free-dmo/free-dmo-stm32/(threads)

Thread 1 (2022-03-29):

CRC algorithm

garci66, 2022-03-29:
Not sure if it helps (and sorry for opening an issue). But in the past I've used this tool to brute force unknown CRC checksums and find the coefficients. https://github.com/nitram2342/bruteforce-crc

Means we probably need a few different samples, but I've used it to decode a protocol with its own CRC and this tool helped me find the proper coefficients. Hope it helps !!!

freepdk, 2022-03-29:
I tried to brute force the poly already. No luck for me.

freepdk, 2022-03-29:
In case you want to try yourself, here one data block (common in all read outs):
```
static const uint8_t crcblk1[] = {
  0x00,0x00,0x00,0x00, 0x00,0x00,0x00,0x00, 0x00,0x00,0x00,0x00, 0x00,0x00,0x00,0x00,
  0x00,0x00,0x00,0x00, 0x00,0x00,0x00,0x00, 0x00,0x00,0x00,0x00, 0x00,0x00,0x00,0x00,
  0x00,0x00,0x00,0x00, 0x00,0x00,0x00,0x00,
};
```
CRC for this is: 0x913ec3dd (or 0xddc33e9 - depending on byte order).

Another one to verify:
```
static const uint8_t crcblk2[] = {
  0x01,0x00,0x00,0x00, 0x00,0x00,0x00,0x00, 0x00,0x00,0x00,0x00, 0x00,0x00,0x85,0x30,
  0xE1,0x07,0x00,0x00, 0x00,0x00,0x00,0x00,
};
```
CRC for this is: 0x8723b272 (or 0x72b22387 - depending on byte order).

garci66, 2022-03-29:
Thanks. Let me see

kategray, 2022-03-29:
Doesn't look like a standard CRC32 algorithm, if the input is correct.

https://crccalc.com/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

dtomcat, 2022-04-13:
If your question/issue is resolved, please close the issue so attention can be focused on open issues.

eychei, 2022-07-18:
Looking into this right now.
How did you find out the block size for the crc?
Do you have a memory map of the Tag data which you identified already?

Thread 2 (2022-03-31):

5XL

dtomcat, 2022-03-31:
Not really an issue (that I know of). But this should work with 5XL right?  Thanks

freepdk, 2022-04-03:
The logic will work 100% for sure.
Just the wiring might be different. In case you have some pictures of the main pcb and the RFID board of the 5XL this could be answered easily.

dtomcat, 2022-04-03:
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

As Requested.

freepdk, 2022-04-04:
The RFID board is identical to the one in the 550. This means the exact same mod will work for the 5XL as well.

To your question regarding the STM32 "compatible" ICs... Hard to tell if it works or not. The firmware uses I2C which might or might not be cloned in a good way... You have to try.

dtomcat, 2022-04-14:
This works with 5XL (confirmed)

Closed 2022-04-04.

Thread 3 (2022-03-31):

Describe RFID board

stappersg, 2022-03-31:
Currently there is no information the RFID board.
It is only seen in a photo.

Please describe the RFID board.

freepdk, 2022-04-03:
The RFID board is very boring. It is just a CLRC663 RFID IC (used in I2C mode) and an RFID antenna.

The NXP datasheet of CLRC663 has all the details: https://www.nxp.com/docs/en/data-sheet/CLRC663.pdf

dtomcat, 2022-04-13:
If your question/issue is resolved, please close the issue so attention can be focused on open issues.

stappersg, 2022-04-14:
@dtomcat  You are right,  thanks for reminding me to do this.

Since a few moments there is merge request #11

Closed 2022-04-14.

Thread 5 (2022-04-04):

How Accomplished

0Kills, 2022-04-04:
This isn't an issue, but are you able to detail how you reverse engineered the protocol/tag format and how it works? I cracked open a 550 and tried to get started reversing the pins between the board and the daughterboard, but I got lost in the process. How did you determine it was I2C, how were you able to reverse the protocol, and how does the protocol work?  Does the digital signature not also sign the blocks that hold the label count? Seems almost pointless for them to use a digital signature when it can just be copied byte for byte.

freepdk, 2022-04-05:
First you identify the ICs on the main board.

==> You learn it is a STM32F072

Then you look at the pinout of the STM32F072 and identify which pins go to the connector for the RFID board.

==> here you learn they are 2 x I2C pins, 1 x GPIO pin, 1 x 3V3, 1 x GND, and 1 pin unknown (this we identify later when looking at the RFID board)

Now you look at the RFID board and identifiy the RFID IC from NXP: CLRC663

==> Again you look at the data sheet and trace the pins ==> you confirm I2C, 3V3 and GND. Then you identify the GPIO pin is connected to IRQ and the unknown pin is in fact PowerDown.

Since you now know all the pins from the cable between main board and RFID board you attach a logic analyzer (e.g. Saleae Logic 8 - or any cheap logic analyzer you can find).

Usually the logic analyzer is having some software which you can use to decode the data (e.g. I2C).

==> You now have the byte stream going in and out via I2C (see here: https://www.eevblog.com/forum/reviews/dymo-550-thermal-printer-drm-hacking/msg4047715/#msg4047715)

Now again you read the CLRC663 data sheet to understand the data going in and out.

==> You find the commands which is just set up the CLRC633 and also the data which is sent to the real tag presented to the reader and also the response from the tag.

Now you look up the data sheet for the tag: NXP SLIX2  and find the meaning of the data sent:

- read UID
- read signature
- read data blocks
- write counter
...

All what is left is to capture the data which is sent / received from real tag and write an emulation to play back this data.

freepdk, 2022-04-05:
> Does the digital signature not also sign the blocks that hold the label count? Seems almost pointless for them to use a digital signature when it can just be copied byte for byte.

The signature is in the SLIX2 specification which just signs the UID (8 byte ID) of the tag.
D.MO at least uses their own signature (own ECC priv key to sign in factory, pub key to verify in firmware), but like you mentioned this does not protect from replay.

==> All in all THIS WAS NOT DESIGNED TO BY SECURE (no intention visible from D.MO).

Like I mentioned before. They used the wrong security scheme... maybe they had to save money :-P

0Kills, 2022-04-05:
Couldn't they conceivably have the private key in a secure enclave inside the device to digitally sign new data blocks after decrement without exposing the key?
Also I've just dumped the data from the 25 x 54mm labels. What is the best way to get to you to add new label emulation?

freepdk, 2022-04-06:
They could have done many things differently... But I see no point in discussing ideas here which would help them or others to make a "better" system. The complete idea is WRONG!

You can attach the dump .txt file here (When you comment here, there is a small text below the edit box "Attach files by dragging...")

0Kills, 2022-04-06:
[E0040108449690ED_20220405143943.txt](https://github.com/free-dmo/free-dmo-stm32/files/8426840/E0040108449690ED_20220405143943.txt)

Good point about not helping them. Label dump for 25x54mm is attached. Thanks for all your hard work.

freepdk, 2022-04-06:
Thanks for the dump. Intgerated with commit: 89fa322

dtomcat, 2022-04-13:
If your question/issue is resolved, please close the issue so attention can be focused on open issues.

RyanEwen, 2023-09-27:
This is great. I have a Zebra ZSB-DP14 thermal label printer which uses refills equipped with tiny little PCBs, just big enough to house 3 pads that align with 3 pins in the printer. I'm hoping to figure out what is communicated between the refill PCBs and the printer so that I'm not locked into their expensive refills.

hinakhan09, 2024-07-11:
Download Now https://pclife.info/dymo-connect-crack/

Thread 6 (2022-04-05):

QUESTION: Compatibility with 5XL

malebuffy, 2022-04-05:
Would this work with the 5XL as well?

freepdk, 2022-04-05:
Was discussed in issue #2 .

==> Should work, since reader board is identical which means the pinout on main board must be also identical.

dtomcat, 2022-04-13:
If your question/issue is resolved, please close the issue so attention can be focused on open issues.

Closed 2022-04-13.

Thread 9 (2022-04-12):

Ready bins

netboy69, 2022-04-12:
Hi, can we please have all bins for all kind of labels? So we dont have to compile or use the reader from the printer? Regards

dtomcat, 2022-04-13:
IMHO if you’re unable to compile… you should probably not do this mod.   The creator has given you everything you need. It would be a lot of work to keep updating bins with each possibility

netboy69, 2022-04-13:
I'm able to compile but just didn't work, if i try the bin that is already done works perfect, but that's not the size of labels that i use. That's why I'm was just asking if anyone can do it. But thanks anyway I'll find a way. Kind regards

dtomcat, 2022-04-13:
What issues are you having? Perhaps the community can help. My blue pills arrive tomorrow so I’ll be attempting everything tomorrow.  The bin is created?  You program the chip and it doesn’t work?  Checked all connections?

netboy69, 2022-04-13:
I got the blue pill and the programer for the pill, but i was missing the 4.7om resisters , so i thought just to use the pill to try, I've change the code to match the label i wanted, compile all under Ubuntu got the final bin, content the pill to printer and wouldn't detect the label size, with the original bin already compiled the printer assume a label no problem. Today i should receive the 4.7 om resisters so I'll build the all thing. And see. Regards

netboy69, 2022-04-13:
Also I'm trying on a 5xl because the original bin worked fine I'll assume all should work 100%, I'll post my result soon and if i manage to compile the bins correctly I'll post them all here it's just quicker, compiling takes time when you do it first time. Regards

freepdk, 2022-04-13:
I created a github workflow which automatically compiles all variants for new releases.
Have a look at the main page / releases section where you can download a ZIP file containing firmwares for all default emulation variants.

netboy69, 2022-04-13:
Omg you are the man, thanks alot, can't wait to get home and program the blue pill. I wanted to do that but I dont know why my bin didn't work because Ubuntu show no errors. One more time many thanks for that. Have a great day.

freepdk, 2022-04-13:
Unfortunately (or fortunately?) I do not have a 5XL.

Since the printer has a different main MCU it might be that they have differences in their firmware implementation which might need some tweaks to the emulation.

However you reported your 5XL with the pre compiled firmware worked already :-)

One thing to note, after changing the firmware on the blue pill, make sure to power cycle the printer completely (remove USB and POWER for 5 seconds). Mine gets upset when I change the blue pill firmware while the printer is running (I use the SWD pins connected to ST-Link, so I can use debugger).

netboy69, 2022-04-13:
By the end of the day I'll post all results, but yes the 5xl worked fine with the default label on the freedom.bin, I'll report the rest later on. Kind regards

netboy69, 2022-04-13:
Hi every one, so here my results on a Dymo 5XL, first tests were made with the STM32 blue pill only and not connected to the reader, i have tested all bins files and the results were: freedmo-default-sku-S0722400_36x89mm.bin, freedmo-default-sku-S0722430_54x101mm.bin and freedmo-default-sku-S0722550_19x51mm.bin the printer detects the label and setups it self for the label size on the other bins files it does not detect the label size meaning if you press the right button to skip a or print blank label because the size is wrong it wont skip the blank label, but if you tell the printer to print a 1744907 for example it will print fine and stops ok on the next label and gives no errors. so it can be used like this just remember to setup the size of the bin you programed and will get the job done. Then my next test was to connect to the rfid reader all seem fine but i dont have original label to test if it reads fine and adjust the size, ill see if i can get genuine labels and come back for a result, but so far with the stm32 blue pill alone works fine you dont need to connect to the reader if you only print one kind of labels.

netboy69, 2022-04-13:
No worries, in the end my bin was the same because both had the same result. I just thought I was doing something wrong because it wasn't working like the original bin. In the end i got the 5xl printing on the 6x4 labels bypassing the RFID so happy days and no money for dymo genuine labels. :-)

dtomcat, 2022-04-14:
My update:  Programmed one Blue Pill into an ST-Link V2...   compiled src (src prior to update with github workflow) to use 4x6 labels.  uploaded resulting BIN to a new Blue Pill (via previously mentioned blue pill) and everything works fine. (I think)  I only have 4x6 labels, so I can't tell if it's detecting my labels or not.  Will this auto top off my labels to 50 if it's below that?  and in the src it says 220 labels, but defaults to 50.  Other than that... seems to work.  I may pick up a pack of other labels to see if it recognizes those or not.

So this confirms that it works fully with 5XL if issues noted above are normal.
Thanks for your hard work on this!

dtomcat, 2022-04-14:
so instead of buying new labels, i tried flashing a different firmware... none worked... either it came up 4x6 (no matter which firmware) or only worked with original labels... reflashed the bin I compiled and now it shows 220 labels no matter which label i insert. (4x6)...  the default... if i load generic labels... it shows 220 labels (as expected)... if i load my roll, it shows 220 which rfid tag says there is 50 labels.

Should it show tag amount if genuine labels?  i can't tell if it's reading the labels or not.

netboy69, 2022-04-14:
On the 4x6 labels it won't detect the label but let say you are painting a pdf on the setting chose the correct label size and it will print. I assume by not drying the label size will also don't know how many labels left.

netboy69, 2022-04-14:
Printing not paiting

netboy69, 2022-04-14:
Windows, go to printers then chose the 5xl then settings and chose correct label size.

netboy69, 2022-04-14:
whats new on the firmware 1.0.5?

dtomcat, 2022-04-14:
Looks like he added 1”x1” label to code

netboy69, 2022-04-14:
Ho ok, I'll try when possible. Thanks

dtomcat, 2022-04-15:
4x6 is the only one that I actually got working.  And i figured out, if you have real dymo labels inserted, then every label inserted after keeps the orginal inserted.  i.e. I insert my 4x6 label (real) with 50 remaining... then insert generic label....   it shows up as 4x6 with 50 remaining.   if I power down and power back up... that same roll shows up as 4x6 with 220 labels...   If I insert the real labels... they also show up with 220 remaining.    all the other pre-compiled bins... would not show any labels ... only real labels... not sure whats wrong... but i'll only be using 4x6 labels in the 5xl... so i'm not worried...    i have it working like i need it to.   I have a different size label coming from Amazon to try out.   I'll follow up with the results.

netboy69, 2022-04-15:
Nice, it's like me i only use the 4x6 and it's printing ok so far so let's see if this issue get fixed next updates about detecting the labels. But I'm happy so far because I can use 3rd party labels.

dtomcat, 2022-04-17:
Tried new Labels... after power cycle... Worked great.  Right labels/remain amount showed...

Loaded 4x6 labels... and showed as new labels...  so even if using real labels, you have to power cycle after each change.  Whatever is loaded upon power up... is the only label that shows until another power cycle.

netboy69, 2022-04-17:
Perfect we can live with that.

freepdk, 2022-04-18:
> Tried new Labels... after power cycle... Worked great. Right labels/remain amount showed...
>
> Loaded 4x6 labels... and showed as new labels... so even if using real labels, you have to power cycle after each change. Whatever is loaded upon power up... is the only label that shows until another power cycle.

Hmmm... maybe we can improve on that. On my 550 when you remove a spool (so RFID board can't see it anymore), wait 3 seconds and put in a new spool it shows the new labels with a fresh maximum counter.

Maybe the 5XL needs some other timing... Anyone with a STLinkV2 connected to the bluepill could debug on 5XL?

dtomcat, 2022-04-18:
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

I can probably help.  Just let me know what to do.  I have a home made ST-Link V2… but should work

dtomcat, 2022-04-20:
I’ll be creating another D.MO today for testing (longer leads). Let me know what you need

dtomcat, 2022-04-20:
Test Blue Pill is ready...  not sure how to get the information you need, so waiting on your response.

dtomcat, 2022-04-21:
I could pull the pin out of the connector instead of desoldering.  (To save time and headache) Just let me know whenever you have time and I’ll do my part

dtomcat, 2022-05-04:
Any update on what you need me to do to get you the data you need?  Do I need a special build?

dtomcat, 2022-07-31:
?????  still supporting this?  if so, I'd like to help troubleshoot the 5xl

dtomcat, 2022-08-03:
Ah. Sorry to hear this

dtomcat, 2022-08-03:
Egg grill

dtomcat, 2022-10-25:
Just checking in to see if I can help?  (Troubleshoot the 5xl

Thread 13 (2022-04-21):

6 pin connector

0Kills, 2022-04-21:
The 6 pin connector recommended in the guide does not seem to match the connector on the board.
The one on the board has notches in the front (or back) while this cable has them on the sides. This is a JST ZH 6 pin cable from Amazon: https://www.amazon.com/gp/product/B07Q5F9CCZ/ref=ppx_yo_dt_b_asin_title_o07_s00?ie=UTF8&psc=1
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

dtomcat, 2022-04-21:
This is what I used:
1.25mm Pitch Connectors and Pre-Crimped Cables Compatible with Molex PicoBlade for Pixhawk Silicone 15cm Wire https://www.amazon.com/dp/B07S18D3RN/ref=cm_sw_r_cp_api_i_XMXH33ZB033DANEVMGSC?_encoding=UTF8&psc=1

freepdk, 2022-04-21:
Actually I used the listing title from ebay which was:  "6pin 1.25mm Wire To Board Connector / JST ZH 6pin"

So maybe the listing I purchased from was wrong or the listing you found on amazon is wrong...

0Kills, 2022-04-28:
The link from @dtomcat worked for me.

GigaElectron, 2022-08-26:
@freepdk JST ZH has a 1.5mm pitch, whereas JST **_GH_** has a 1.25mm pitch, the listing you used must have been incorrect. The `README` should be changed to say "JST GH". 👍

freepdk, 2022-08-28:
I changed the README to say GH (see commit 02bf8f9)

soerendohmen, 2023-06-23:
GH is definitely not the correct connector, as you can see on the picture on JST's website: [https://jst.de/product-family/show/89/gh](https://jst.de/product-family/show/89/gh)

queengooborg, 2023-09-15:
It appears that the GH connector is commonly confused with the Molex PicoBlade (MX) connector.  They're both the same pitch (1.25mm).  I've updated the readme on my fork (https://github.com/queengooborg/free-dmo-stm32#required-parts) and will be submitting a PR to help correct this info upstream!

Thread 14 (2022-05-07):

Add SKU S0722540 (32x57mm) in dumped SKUs

BarthV, 2022-05-07:
This ref seems missing in the main.c SKU (& my wife desperately needs it ;D) :

**S0722540 - 32 mm x 57 mm | 1¼ in x 2¼ in - 1.000 labels**
_Dumped using https://github.com/free-dmo/free-dmo-tag-dump_

inventory :
```0x01, 0x49, 0xCA, 0x4D, 0x44, 0x08, 0x01, 0x04, 0xE0```

sysInfo:
```0x0F, 0x49, 0xCA, 0x4D, 0x44, 0x08, 0x01, 0x04, 0xE0, 0x01, 0x3D, 0x4F, 0x03, 0x01```

signature:
```0xE1, 0x59, 0xA4, 0x09, 0x08, 0xF1, 0xE6, 0x00, 0x25, 0x5F, 0x59, 0x96, 0x8C, 0x16, 0x96, 0x7B, 0x81, 0x52, 0xA8, 0x4C, 0x09, 0xDE, 0x4C, 0x2E, 0xDF, 0x9B, 0xB3, 0x65, 0x5C, 0x1E, 0x00, 0x20```

BarthV, 2022-05-07:
will copy the bocks too, and maybe write a PR

Closed 2022-06-17.

Thread 15 (2022-05-21):

STM32F103C6T6

malebuffy, 2022-05-21:
Hi since I have a STM32F103C6T6 around which is not compatible,  I would be interested to know why? Is this a limitation of Hardware or just that the source is written to be compiled for the STM32F103C8T6?

malebuffy, 2022-05-22:
I tried to create a new project with the CubeMX application and use the .ioc file and import it in a STM32F103C6x project. At first seems to work and code is generated, but after that I am kind of struggling. The main difference is that the CubeMX doesn't generate a .ioc file that has I2C2 defined, and it doesn't build.

Any idea what is happening?

malebuffy, 2022-05-23:
So after further diging in, the STM32F103C6T6 has only one I2C channel and the code needs 2, so thats probably why this is not compatible.

Closed 2022-05-23.

Thread 16 (2022-05-28):

How to debug for message: Unknown label detected

malebuffy, 2022-05-28:
Hi guys,

I received my bluepill with what it seams a STM32F103C8x ship on it. At least it looks legitimate. I tried both flashing the bin files and also compiling anf flashing the freedmo.bin. Wire connections are OK, I am using the 4.7k resistors as well in order to be able to recognize different spools.

After flashing, I connect the bluepill to the printer and when I switchit on it says: Unknown Label Detected

No matter which Bin I flash, same thing. Do you have any tips for me how to debug? I am getting kind of desprate...

Thanks for any feedback

malebuffy, 2022-05-29:
Checked all the pins, checked connections. All good. Can it be that because I am using the latest Dymo Software v1.4.3.131 that they blocked the UIDs? Anyone has an older version I could try?

dtomcat, 2022-05-31:
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

also ensure jumpers are right

dtomcat, 2022-05-31:
![Uploading FA5F8487-D94C-433E-9FAC-7502DD37C0E0.jpeg…]()

dtomcat, 2022-05-31:
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

malebuffy, 2022-05-31:
Oh sorry, silly me! Yes, the jumpers are like this. I never touched them.

malebuffy, 2022-05-31:
No problem. So does it work on your 5XL? Do you use an original STM32 or some clone?

dtomcat, 2022-05-31:
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

This is the change for me.  Without troubleshooting, this is how it works for me… but is ok for me as I don’t change labels frequently

malebuffy, 2022-05-31:
I will try to build your fork and report back. BTW do you use original STM32 or clone?

dtomcat, 2022-05-31:
My fork is basically the same… just added a new label. And updated the readme.

As far as I know… it’s original. But cloners are good!

malebuffy, 2022-05-31:
Nothings works. I am starting to think that I have a fake STM and somehow the peripherals are not correctly cloned. I removed the resistors and disconnected the RFID part, still receiving an error. Sadly not easy to debug like an arduino for exampl3 where you just read from serial monitor.

I have ordered a new one to see if I have better results.

malebuffy, 2022-06-01:
Fixed it! It was a bad board. I used another one and remade the connections. It works now without the resistors and the RFID board, but I will try that in the evening and report back!

malebuffy, 2022-06-01:
I did it. Board was the culprit. Bad luck I guess. I can confirm the same behaviour when I have an original roll in. I have to power cycle.

malebuffy, 2022-06-01:
Thanks to dtomcat for the support and to the author for the mod.

dtomcat, 2022-06-01:
No worries. I figured it had to be a bad board if everything else i mentioned was good. Glad you got it working.  And good to know yours functions same as mine.  So must be a timing issue (difference between 550 and 5XL)

Thread 17 (2022-05-31):

Add SKU

malebuffy, 2022-05-31:
104mm x 159mm Label SKU S0904980

```
inventory: 0x01,0x49,0x4E,0xB1,0x44,0x08,0x01,0x04,0xE0
sysInfo: 0x0F,0x49,0x4E,0xB1,0x44,0x08,0x01,0x04,0xE0,0x01,0x3D,0x4F,0x03,0x01
signature: 0x9C,0x42,0x9E,0x45,0x08,0xEF,0xA2,0xA5,0xF0,0x05,0xFC,0x86,0x27,0x37,0x98,0xF5,0xA5,0x9F,0xA2,0x87,0x20,0x9B,0x15,0x09,0x83,0x42,0x8E,0x64,0x3C,0x7A,0xC9,0xB9
blocks:
0x03,0x0A,0x82,0xED,0x86,0x39,0x61,0xD2,0x03,0x14,0x1E,0x32,0xB6,0xCA,0x00,0x3C,0x86,0xD3,0x18,0x6B,0x53,0x30,0x39,0x30,0x34,0x39,0x38,0x30,0x00,0x00,0x00,0x00,0x00,0xFF,0x04,0x01,0x01,0x00,0x00,0x00,0x73,0x06,0x1E,0x00,0x26,0x00,0x00,0x00,0x00,0x00,0x10,0x00,0x3A,0x06,0x14,0x04,0x00,0x00,0x00,0x00,0x33,0x04,0xDC,0x00, 0xF1,0x46,0x16,0x00,0x01,0x00,0x00,0x00,0x00,0x00,0x00,0x00,0x00,0x00,0x00,0x00,0xD7,0xFA,0x00,0x1C,0xEC,0x16,0x52,0x70,0x00,0x30,0x30,0x30,0x30,0x30,0x30,0x30,0x30,0x30,0x30,0x00,0x00,0x00,0x8E,0x05,0x2E,0x00,0x00,0x00,0x00,0x00,0x00,0x00,0x00,0x00,0x00,0x00,0x00,0x00,0x00,0x00,0x32,0x8C,0x00,0x30,0xB6,0x6B,0x7D,0x6A, 0x00,0x00,0x00,0x00,0x9D,0x01,0x96,0x5E,0x00,0x00,0x00,0x00,0x00,0x00,0x00,0x00,0x00,0x00,0x00,0x00,0x00,0x00,0x00,0x00,0x00,0x00,0x00,0x00,0x00,0x00,0x00,0x00,0x00,0x00,0x00,0x00,0x00,0x00,0x00,0x00,0x00,0x00,0x00,0x00,0x00,0x00,0x00,0x00,0x00,0x00,0x00,0x00,0x00,0x00,0x00,0x00,0x00,0x00,0x00,0x00,0x00,0x00,0x00,0x00, 0x00,0x00,0x00,0x00,0x00,0x00,0x00,0x00,0x11,0xF3,0x00,0x2C,0xDD,0xC3,0x3E,0x91,0x00,0x00,0x00,0x00,0x00,0x00,0x00,0x00,0x00,0x00,0x00,0x00,0x00,0x00,0x00,0x00,0x00,0x00,0x00,0x00,0x00,0x00,0x00,0x00,0x00,0x00,0x00,0x00,0x00,0x00,0x00,0x00,0x00,0x00,0x00,0x00,0x00,0x00,0x00,0x00,0x00,0x00,0x00,0x00,0x00,0x00,0x00,0x00, 0x00,0x00,0x00,0x00,0x00,0x00,0x00,0x00,0x00,0x00,0x00,0x00,0x00,0x00,0x00,0x00,0x00,0x00,0x00,0x00,0x00,0x00,0x00,0x00,0x00,0x00,0x00,0x00,0x00,0x00,0x00,0x00,0x00,0x00,0x00,0x00,0x00,0x00,0x00,0x00,0x00,0x00,0x00,0x00,0x00,0x00,0x00,0x00,0x00,0x00,0x00,0x00,0x00,0x00,0x00,0x00,0x00,0x00,0x00,0x00,0x0D,0xFF,0x00,0x01

```

freepdk, 2022-06-17:
added with commit: 5a5f46886a5a8df8aceb689dcb433f01ada72525

Closed 2022-06-17.

Thread 19 (2022-07-17):

Feature request: next label typd on reset

eychei, 2022-07-17:
Hello,

Thank you for the nice tool.
I did install it on a 5XL without issues.

Just a feature request.
If we could change the label type when pushing the reset button, that would be great.
Or just install a new button on one of the inputs to switch label types. That would be great.

Thank you for giving us our freedom back:)

Thread 20 (2022-09-15):

power reset issue

jody-steele, 2022-09-15:
i am having an issue with the 550 seeing labels as supported after a power off and back on. to get it back to seeing supported labels i have to click the reset button on the stm32. otherwise its working ok. maybe a flash issue but I have tried re-flashing and full erase but stil running into the issue.

also you listed 4.7k ohm res but I couldn't tell if they are half 1/2w or what. can you add more info on which 4.7k Ohm to use.

jody-steele, 2022-09-15:
is there anything I need to do for programming the stm32 so that on power on its ready to go. I am using the 30256 bin file if that matters.

jody-steele, 2022-09-29:
Any help would be great. every time the device powers on i have to hit the reset button the bluepill and then it works great. at least until the next power off and on.

freepdk, 2022-10-09:
Hi,

It's hard to diagnose your problem.

The resistor just needs to be 4.7k with almost no wattage requirements. It is just a pull up. So really any 4.7k resistor you can find will work.

If your bluepill has startup problems you should check if your have a genuine STM32F103 or a clone. Sometimes the clones do have different behavior which might or might not be tweeked with firmware or hardware modifications.

jody-steele, 2022-10-09:
Issue is that a reset resolves the problem. So, I built the reset button onto the back of the printer. If I send a link to the Amazon item could u check it and see if it looks right?

Thank you

Sent via the Samsung Galaxy S21 Ultra 5G, an AT&T 5G smartphone
Get Outlook for Android<https://aka.ms/AAb9ysg>
________________________________
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

freepdk, 2022-10-09:
A picture of your actual bluepill (most interesting the labeling on the main / biggest IC) would reveal the truth.

Here is a very nice writeup from keirf:

https://github.com/keirf/Greaseweazle/wiki/STM32-Fakes

The first picture is a "good one", all following ones are fakes with problems.

Thread 21 (2022-09-21):

How to download the firmware to the bluepill?

samiultahir, 2022-09-21:
Hi there. Apologies for the noob question but the guide is quite vague. How would you go about writing the precompiled firmware tot he bluepill?

Every guide I've checked says I need an extra piece of hardware (i.e. serial adapter) which wasn't listed at the top of the page:
"1 × STM32F103 bluepill
search for: STM32F103 bluepill / STM32F103 bluepill with STLinkV2
::ATTENTION:: Make sure your blue pill is using the correct STM32F103C8T6. Some places sell blue pills with STM32F103C6T6 which are not compatible.

2 × cable
search for: 6 pin 1.25 mm / 6pin 1.25mm Wire To Board Connector / JST GH 6pin

2 × resistor 4.7kΩ"

Can i not just plug a micro usb cable in and write it from there?

Any help would be appreciated! Thanks.

Closed 2022-09-24.

Thread 22 (2022-11-06):

Tag Data

lightkeepr, 2022-11-06:
How do I send you the tag data I read off of a 30270 Receipt paper roll?

freepdk, 2022-12-01:
You can attach the file here (there is a "Attach files by dragging..." on the bottom of the edit box when you add a comment.

lightkeepr, 2022-12-06:
[E004010851A29555_20221106152105.txt](https://github.com/free-dmo/free-dmo-stm32/files/10161097/E004010851A29555_20221106152105.txt)

Should be attached!

czester1994, 2023-08-03:
[E004010849D4BD04_20230803163323.txt](https://github.com/free-dmo/free-dmo-stm32/files/12251927/E004010849D4BD04_20230803163323.txt)
@freepdk could you compile this for .bin file? It`s data tag from S0722530 label (1/2"x1" or 13x25mm)

queengooborg, 2023-09-15:
I've implemented both of these SKUs in a fork and compiled firmware accordingly, hope it helps! https://github.com/queengooborg/free-dmo-stm32/releases/tag/v1.0.8

Thread 23 (2022-11-13):

1). Bluepill free pins to select label type, 2). Similar hack for Niimbot D11 printer

mesmariusz, 2022-11-13:
Hi

1). It looks to be not so easy to collect RFID used labels for all existing types of labels.
What do you think about using some free pin(s) to make label type select via pultiple presing a single switch or use a few switches connected do a few free bluepill pins ?

2). Possible for you to prepare similar hack for the most popular printer from AliExpress (Niimbot D11) ?
They are even more perfidious tan Dymo., because oficially they don't announce that there is DRM included. If you put a lables without RFID, then you can officially set used label dimensions and printing is possible, but the quality is so much decreased that this is not possible to read the labels, especially small characters.

The greates perfidy is because they tried to tell to the customers: "We are good for you, we let you print on our competitors labels, but as you see the labels from our competitios are so bad regarding the quality, that as you see you need to buy the labels from us officially".

This is completly bullshit!

You can see that by putting competitor's labels and put oryginal RFID inside together (perfect printing quality again).
Or even if you have original labels inside but RFID counter limit has been excessed, then the quality is swither to almost unreadable.

Could you please try to fight also with them against so much unfair practice ? They are even worse from Dymo in that case...

Thread 24 (2023-01-02):

Need help setting up the board.

dylanstoel, 2023-01-02:
Hi there,

I'm pretty new to uploading the code to the bluepill and can't seem to find out how to do it, can someone help me with this?

Thanks in advance.

jbdunn82, 2023-03-23:
I am also having one heck of a time as the Hardware failed to mention you needed the serial to usb adapter. I have read where you can upload a bootloader so you can use the onboard usb micro but in order to dop that you have to use the adapter first. Ther eis also the jlink way and you have to have the adapter for that as well. Needless to say as a beginner on here to STM or Arduino whatever, the instructions are lacking. I just need someone to point me in the right direction.

KudzuKid, 2023-09-10:
I am having similar issues. This is a different beast than any Audrino I've played with.  I suspect Bluepill is the answer due to it's tiny footprint and installs easily in the device.  However, for those who are lacking firmware flashing procedures, can someone clarify / flesh out the process a bit?

I  saw the note about needing to acquire a [cable ](https://www.amazon.com/dp/B07R8BQYW1?ref=ppx_yo2ov_dt_b_product_details&th=1) and I have that.

Also, I've done the soldering, etc. Easy peasy (for me).  But the firmware side is a bit confusing in the article if you've never done this before. But otherwise, I'm entirely confused. I've tried a couple of YouTube videos but those seem equally ambiguous.  Some things say I need a USB dongle thing, but other articles suggest I don't.  FWIW, I have "STM32CubeIDE 1.13.1" - but have never used it - is it needed for this project?  PLEASE NOTE:  I don't intend to write my own (unless I absolutely had to!)  -  as I believe the images for the 2 main label types I use are already available.  Knowing that, how do I proceed?

Can anyone point us in the right direction?! Please and THANK YOU!

queengooborg, 2023-09-15:
The firmware flashing was something that had greatly confused me as well, so I just overhauled the setup documentation and wrote a detailed guide on how to flash the firmware on the bluepill!  https://github.com/queengooborg/free-dmo-stm32#install-the-firmware

Hope this helps!

Thread 25 (2023-01-22):

No Issue - Just Thanks!

refporef, 2023-01-22:
I bought the printer without noticing its shameful behavior (despite reading the documentation upfront). Thanks for your project and the effort you put in!

Thread 27 (2023-02-25):

Does this actually allow unlimited prints?

MeisterLone, 2023-02-25:
As far as I can tell, when all the available UID's saved in the firmware are used up, the device wont allow printing anymore?

Or am I missing something

MeisterLone, 2023-02-27:
Anybody?

dtomcat, 2023-03-31:
D.MO RFID tag emulation

After startup of the printer a default tag emulation is used which can be defined in the firmware. The emulation will count down correctly until the end of the roll is reached. A power cycle / sleep+wakeup of the printer is enough to reset the emulated tag counter back to it's maximum.

If the original RFID board is also connected and a spool with D.MO RFID tag is found then the emulation data is updated with the data from this RFID tag. Just the counter will be emulated in this case. This enables the use of any D.MO format unless you have at least one original spool (you can peel the RFID label of that role and attach it to the inside of the printer).

MeisterLone, 2023-03-31:
Thank you, in the meantime I have tried it out. Very cool solution to the problem! I actually started my research into this device before knowing that this exists. I read the little spi chip that is on the device and found it to be entirely empty. I tried to dump the stm32 flash and it was readout protected. Next step was going to be fault introduction. Very clever solution you have here indeed. Did it take you a long time to decode what was beijg communicated by i2c?

Thread 28 (2023-03-24):

Unable to get working

TheIgnorantDev, 2023-03-24:
I've followed all steps for soldering and programming. Insured the board is correct blue pill even reused the connector from the RFID board to mobo and soldered that to the blue pill board.

In testing the blue pill powers up. The blue light flashes at boot of the printer. But afterword the 2 of the 3 front lights start flashing on the printer. The same sign that there isn't any labels detected. The connect software says there is a printer on but no labels in the printer.

Is there any way to debug and try to get this issue resolved or get any advice to something I've possibly missed?

Edit: I've both compiled the src and tried precompiled binaries from the release section. I'm not running with the rfid reader attached. Only the blue pill connected to the motherboard of the printer.

wr420, 2023-09-02:
I believe I am having a similar issue.  I have 4 printers and 4 bluepills.  I successfully installed a precompiled bin file via an FTDI programmer for all 4 pills.
I tested the first printer and it worked as expected and continues to.  The other 3 are giving me problems and I can figure it out.  Also running without the RFID reader.
They all show error in windows and I have tried reflashing several times and with different bin files for various label sizes.   I have used cube32 and ST Flash demo to flash with.

Closed 2024-09-05.

Thread 29 (2023-05-14):

Unable to upload firmware

verisgit, 2023-05-14:
Hi there, I can't figure out your instructions to upload the firmware. The steps say wire and configure the device, which I've done. My understanding was that the entire point of the STM32F103C6T6 version was that the firmware could be installed over micro-usb? Otherwise why are we wiring up the device before installing the firmware (which in all other methods requires alternative wiring and would surely be the first step before installing all the other wires for the Dymo interface?)

https://www.electronicshub.org/how-to-upload-stm32f103c8t6-usb-bootloader Says the STM32F103C6T6 can upload firmware by MicroUSB but then has no instructions on how to do it.

Is there a way to get the firmware to upload without having to solder a USB adapter onto the board?

verisgit, 2023-05-17:
I figured it out, and basically gave up on trying to upload firmware by MicroUSB, despite it apparently being possible.

I purchased a USB UART TTL off Amazon, and soldiered on some pins so I could connect and disconnect jumpers to the TX and RX. I used the MicroUSB for power (no need to connect the USB UART cable's 5v. BUT you do need a common ground or nothing will work! so I plugged the USB UART cable's ground wire into the ground on the 4-pin on the end of the board - which worked a treat). I was then able to upload the firmware.

Closed 2023-05-17.

Thread 31 (2023-08-31):

[INFO] 6-pin JST 1.25mm connector

Mathero11, 2023-08-31:
For anyone wondering. The info has wrong information, **it isn't ``JST _GH_ 6pin``**
It's just a regular >> `JST 1.25mm 6 pin.` <<

Aliexpress link: https://www.aliexpress.com/item/1005001649158434.html

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

queengooborg, 2023-09-15:
There isn't actually such a thing as "regular JST".  JST only has one 1.25mm pitch connector, and that is the GH variant.  But the connector used is definitely not the JST-GH.  So, what's the real deal?

What's actually going on here is that the connector is a Molex PicoBlade -- in other words, a connector that isn't designed by J.S.T. Mfg. Co., and therefore isn't a "JST".  Unfortunately, "JST" is incorrectly used as an all-encompassing term to describe this style of connector.  Because "JST" is often misused in this way, you'll often find matching listings when searching for "JST 6 pin".

I've updated the readme on my fork (https://github.com/queengooborg/free-dmo-stm32#required-parts) and submitted a PR to help correct this info upstream!

Thread 33 (2023-09-11):

Reading SKU frum NFC business card not possible

thitcher, 2023-09-11:
tried to read the SKU from a business card.
Wrote the text S0722520 on the card and tried to use the card to switch the roll.
But the card is not recognized by the printer, what can I try to get it to work?

Got this tip from the forum:
_Switching between rolls can be done using either another original roll (which is then learned) or by using a simple of the shelf NDEF Tag where you just write the SKU of the roll (e.g. "S0722430") inside (like you do with business card information, any phone can do this nowadays).
So by presenting either an original roll the complete data is learned, or by presenting a normal RFID NDEF tag with the SKU inside to choose from the pre installed tags is enough to switch between rolls.
This makes it possible to modify the printer once and then no need to open again in order to switch roll types._

queengooborg, 2023-09-17:
It's not as simple as writing the SKU as text to the NFC tag.  If you want to go that route, you'll have to copy the data from an existing RFID tag to the NFC business card, using an app like NFC Tools or a tool like the Flipper Zero.

Thread 36 (2023-11-28):

I need a little help.

OGStyle, 2023-11-28:
My 550 Turbo doesn't have a crystal next to the rfid connection.  Looks like the board is probably a different model. Has anyone ran into this issue?

Can you post a link to the wiring harness that I need to get?

Thank you

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

stylingig, 2024-01-05:
Hi I got this version of PCB as well, just follow the color version photo and connect it accordingly, and it works fine

OGStyle, 2024-01-05:
I went a head and did it. Thanks.

Thread 39 (2024-03-10):

Wirigh connector

OGStyle, 2024-03-10:
Do you have a link to buy the female connector with wires on it? Thank you

KudzuKid, 2024-03-16:
For the **5XL** it appears to be a Molex 6 pin Picoblade, NOT a JST ZH, GH or SH, etc.   I can't speak to the other printers, but I wouldn't think (even) Dymo would change connectors across printers - they'd want to use a common board as much as possible I would think.

queengooborg, 2024-03-26:
I can confirm that the 550 also uses a Molex Picoblade connector.  I used the following product from Amazon for this project: https://a.co/d/9R8hogO

If you don't like/have Amazon, [Adafruit](https://www.adafruit.com/product/4926) is also a good choice.  You can also search for any of the following on your favorite stores: `6 pin Molex PicoBlade 1.25 mm` / `6pin 1.25mm MX Wire To Board Connector` / `JST MX 6pin`

(The instructions on the main branch incorrectly state the connector is a JST GH connector -- I have a [PR open](https://github.com/free-dmo/free-dmo-stm32/pull/34/files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) to fix that!)

KudzuKid, 2024-03-26:
Yeah, I saw your PR yesterday, I think commented on it.

I used https://www.adafruit.com/product/4986 but didn't see your suggestion
until just now. Wish I saw it a couple months ago - that would be better
than my choice. Just chop that cable in half and you'd have both connectors
for the BluePill !

However, since the Dymo (5XL at least!) doesn't use the JST connector, the
https://www.amazon.com/dp/B07S18D3RN kit didn't do me any good (I bought it
or one extremely similar) off

Amazon when I thought it was a JST style.  By research and processor
elimination, I have since learned it's a Molex Picoblade (not a GH or SH or
ZH).

I appreciate your support and the Git PR - I am not familiar with GutHub
much at all - and this was my first real use of it and didn't know how to
submit those corrections other than making comments as I went along.

*The hack worked like a champ on my 5XL*.  The only thing I would
offer/suggest is maybe some electrical tape on the back of the 'Pill so it
doesn't accidentally short on any other components.  I've thought about
running a little extension of the USB port from the 'pill out the back to
avoid having to re-flashing the BluePill if I decide to change label types.
Any reason why that might not be practical? I'd hate to have to keep
removing those metal screws in the plastic chassis of the 5XL every time I
need to get at the 'Pill.

You're the only person I've seen active on this project lately, so glad to
chat with you.

Cheers!

On Tue, Mar 26, 2024 at 1:36 PM queengooborg ***@***.***>
wrote:

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

Thread 41 (2024-03-16):

Resistor 4.7kΩ

forkyboy, 2024-03-16:
Hello,

I'm currently searching for a 4.7kΩ resistor, but I'm quite new to this and noticed there are various types of resistors available. Could you help me figure out the wattage I need for such a resistor? For instance, when I look on Amazon, there are many versions of a 4.7kΩ resistor, and I'd appreciate any guidance you could provide.

https://www.amazon.com/s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

Also, I have a secondary question: Is Dymo implementing DRM to the extent that they take legal action against individuals who modify their printers? I'm curious because it seems odd that there isn't a market for modified Dymo 5XL printers, given this context.

Thank you very much for your help!

KudzuKid, 2024-03-16:
I suspect even the 1/4W would be fine, but use 1/2W if you just want peace of mine. Anything over what you really need isn't hurting anything, and usually gets more into issues of physical space & placement.   We're not dealing with a 1500W hairdryer or toaster oven here. These are low current, low-voltage circuitry here. 4.7K Ohm are extremely common.  As to WHY they are used, Let Me Google That For You... See here:
[](https://www.jotrin.com/technology/details/what-is-a-4k7-resistor-4-7k-ohm-resistor-color-code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,generate%20a%20precise%20frequency%20signal.)

forkyboy, 2024-03-16:
Thank you, everything is clear for my build now.

I appreciate all the infos.

________________________________
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

KudzuKid, 2024-03-16:
> Thank you, everything is clear for my build now. I appreciate all the infos.
> […](#)
> ________________________________ From: Kudzu Kid ***@***.***> Sent: Saturday, March 16, 2024 1:58:52 PM To: free-dmo/free-dmo-stm32 ***@***.***> Cc: forkyboy ***@***.***>; Author ***@***.***> Subject: Re: [free-dmo/free-dmo-stm32] Resistor 4.7kΩ (Issue #41) I suspect even the 1/4W would be fine, but use 1/2W if you just want peace of mine. Anything over what you really need isn't hurting anything, and usually gets more into issues of physical space & placement. We're not dealing with a 1500W hairdryer or toaster oven here. These are low current, low-voltage circuitry here. 4.7K Ohm are extremely common. As to WHY they are used, Let Me Google That For You... See here: <https://www.jotrin.com/technology/details/what-is-a-4k7-resistor-4-7k-ohm-resistor-color-code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,generate%20a%20precise%20frequency%20signal.> — Reply to this email directly, view it on GitHub<[#41 (comment)](https://github.com/free-dmo/free-dmo-stm32/issues/41#issuecomment-2001995314)>, or unsubscribe<https://github.com/notifications/unsubscribe-auth/AI5DVO67UHISBA4QXUCZJLLYYRFZZAVCNFSM6AAAAABEZF7EC6VHI2DSMVQWIX3LMV43OSLTON2WKQ3PNVWWK3TUHMZDAMBRHE4TKMZRGQ>. You are receiving this because you authored the thread.Message ID: ***@***.***>

Updated with just another thought or two.

Thread 43 (2024-04-06):

RFID BOARD usage ?

forkyboy, 2024-04-06:
Hi everyone,

I've successfully completed the build, and I'm thrilled with the progress. My next step is to integrate an RFID board. My understanding is that this addition will enable compatibility with various paper sizes. However, I'm uncertain about the software integration:

What specific actions are required on the software side to support this feature?
Is there a particular binary file (bin) I need to include in the build to facilitate this? Do I need to incorporate all available binaries, or is there a specific one designed for managing multiple paper sizes?
I apologize if my questions seem basic; English is not my first language, and I'm trying to navigate this project with a limited understanding of the technical terminology. Could someone guide me on how to achieve compatibility with multiple paper sizes using the RFID board? Your assistance would be greatly appreciated. Thank you!

KudzuKid, 2024-04-06:
Hi There,

I'm not sure if this will help or hurt. Rest assured, the _intent_ is to help

OK, so you say you've "completed the build" - I presume you mean you just completed the Blue Pill hookup? That's what the basis of my additional comments will be made on.

So, based on your question, I'm thinking you haven't yet flashed (loaded) a .bin to the Blue Pill. You'll want to do that  after you complete your soldering.  In order to accomplish that, you'll need something like this:

[ST-Link V2 Emulator Downloader Programmer](https://www.amazon.com/gp/product/B07SQV6VLZ

It doesn't have to be this exact one, but something like it - there are others.  So one end of that (USB) plugs in to the host PC with the .bin on it.

The other end gets connected to the Blue Pill.

Which .bin do you need?  That depends!  :-)   Which label do you want to use in your printer?  Each .bin corresponds to a different label type.  There are shipping labels, address labels, "hello" name tag labels, etc.   The number of the .bin corresponds to the D*MO part #.  If you have an original D*mo box ("Authentic" or old school - doesn't matter) there's probably a part # on it. Look for (that part #)  + ".bin" and that's the one you want to flash the Pill with.  Or check Amazon, OFfice Depot, etc. They always show the part # - it's the default info needed to buy the correct label people need.  Does that make sense?

Note: Changing label sizes / types is a bit annoying - you'll need to pull the screws and re-flash it with the appropriate .bin for the next label.  I'm pondering just "outboarding" the connector (or an extension on it, to be precise).

Hope something here helps!

eha002, 2024-09-23:
I think i can help here. There is no software change for bypassing vs intercepting, if no NFC tag is present both just emulate a single Chip

With the intercept setup, on bootup, the Bluepill copies the tag data if present and emulates that tag instead.
It prevents the dymo from updating the chip so you only need 1 genuine roll of that size and can then go aftermarket and reuse them,
![Uploading IMG_2409.jpeg…]()

I'm developing a 3d printed tag holder currently to for easier hot swapping rolls.

-

A few trains of thought here on whats best for you, it will depend on Which printer you use and how often you swap barcodes, if you print direct or via dymo app, etc etc.

if you outline how you mainly use and how often you swap i can make more targeted recommendations

-

To break it down a lot, The NFC reader isn't that useful to you unless you:
Print more than 220 Labels at a time
Use Dymo App & Swap label sizes Regularly
Use Dymo App & Don’t like it complaining that the selected Labels are wrong.

another limitation is you cant print bigger paper than the Programmed Bin File.

so a board programmed as SD0904980 will allow you to print up to 220 Labels of any size that are 4XL compatible as long as you manually select the label you have installed in dymo, or correct paper size in Direct printing.

kestutiz, 2025-01-30:
Probably with little modification possible to program bluepill via USB. As I read for reprograming no need to move jumper in this case. Just upload bootloader and then program via USB. Not tested yet. If it works, then just make hole for USB to go outside the case.

Thread 44 (2024-04-08):

How to compile new firmware in Windows

BaronPils, 2024-04-08:
I very like this solution. But, I have a new role, for which no compiled Firmware is available (yet)

I was succesfull on retrieving the data with NFC from the tag.

But compiling the firmware is not working by running make, which method do you use for compiling firmware in windows?

See following info for input data in makefile and also the error I get...
Please help, since I would like to be self-propelling ;)

BaronPils, 2024-04-08:
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

BaronPils, 2024-04-09:
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

Closed 2024-05-20.

Thread 45 (2024-05-20):

30324 Please?

SoulGit, 2024-05-20:
Anybody have 30324?  No android device to run the dump from . . .  Thx!

queengooborg, 2024-07-10:
Just bought a roll and scanned the tag!  Firmware is available in the latest release of my fork!  https://github.com/queengooborg/free-dmo-stm32/releases/tag/v1.0.14

SoulGit, 2024-09-26:
Thank you so much!

Thread 46 (2024-06-17):

Data Label for 11356

fefed22, 2024-06-17:
Hello,

anyone have data for SKU 11356 ?

Thanks in advance.

Best regards

KudzuKid, 2024-06-17:
Hi There,

YAMMV, but it appears that is also known as the S0722560.  Unfortunately,
that won't help.  I don't see that one in the .bin's either. Maybe you
could buy a roll and read the (NFC)  core (and share it!).  Just a
thought.  Best wishes.

Can anyone else help?

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

fefed22, 2024-06-19:
Hello,

buy a roll is not a problem, but do you have a helper to extract the NFC core ?

Best regards

fefed22, 2024-06-19:
i see this repo : https://github.com/free-dmo/free-dmo-tag-dump
i will test it and come back to you... :)

fefed22, 2024-06-19:
This app crashed everytime i want to launch it !
Do you have another one ?

fefed22, 2024-06-19:
i think that my phone have no NFC reader !

fefed22, 2024-06-20:
I've succeeded to read the NFC from the standard roll include with the machine.
So i will test it on the real roll :)

KudzuKid, 2024-06-20:
Wishing you success...

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

fefed22, 2024-06-25:
Hello,

i've dump the source from roll.
i've installed ARM toolchain
i've put the source file at the root folder of this git archive.

But when i'm starting the make command i've an error :
`Src/main.c: In function 'InitEmulationWithDefaultData':
Src/main.c:1021:31: error: 'DMO_TAG_SLIX2_BLOCKS' undeclared (first use in this function); did you mean 'EMU_SLIX2_BLOCKS'?
 1021 |   memcpy(EMU_SLIX2_BLOCKS,    DMO_TAG_SLIX2_BLOCKS, SLIX2_BLOCKS*sizeof(uint32_t));
      |                               ^~~~~~~~~~~~~~~~~~~~
      |                               EMU_SLIX2_BLOCKS
Src/main.c:1021:31: note: each undeclared identifier is reported only once for each function it appears in
make: *** [build/main.o] Error 1
`

Do you have any suggestion ?

Best regards

fefed22, 2024-06-26:
@KudzuKid i've attached the source file if you could compile file in your side.

Best regards
[E00401085A6683B9_20240624123402.txt](https://github.com/user-attachments/files/15983784/E00401085A6683B9_20240624123402.txt)

KudzuKid, 2024-06-26:
I'm just a user here, I don't know if I can store anything in a repository,
etc.

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

fefed22, 2024-06-27:
Ooooh Sorry.
@brainiak4431 could you please see this thread ?!

fefed22, 2024-07-09:
Hello, @queengooborg can you look at this thread ?
i've attached the source file above.

Thanks

queengooborg, 2024-07-09:
Thanks for providing a dump file, I added it to my fork and just created a release, available here!  https://github.com/queengooborg/free-dmo-stm32/releases/tag/v1.0.13

fefed22, 2024-07-09:
Yeah ! Perfect.
i'll test it when i'm receive pin cable...

ChrisGru01, 2024-07-24:
> Thanks for providing a dump file, I added it to my fork and just created a release, available here!  https://github.com/queengooborg/free-dmo-stm32/releases/tag/v1.0.13

Can you explain to me exactly how to compile the bin? I keep getting the error as the user mentioned above.

fefed22, 2024-08-20:
Pin cable received, bluepill board installed and my printer works very well with my old label rolls !
Thanks for your help.

fefed22, 2024-08-20:
I close my issue.

ChrisGru01, 2024-08-20:
> Pin cable received, bluepill board installed and my printer works very well with my old label rolls !
> Thanks for your help.

Which printer do you use the bluepill with?

ChrisGru01, 2024-08-20:
> Pin cable received, bluepill board installed and my printer works very well with my old label rolls !
> Thanks for your help.

Which printer do you use the bluepill with?

fefed22, 2024-08-20:
I'm using Dymo LW 550 ;)

Closed 2024-08-20.

Thread 47 (2024-07-24):

Error while trying to compile

ChrisGru01, 2024-07-24:
Hey,

First of all, sorry for my bad English.

I wanted to compile my own .bin because it wasn't available for download. Unfortunately I encounter the following error with the "make" command. what do I have to declare there?:

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

I also wanted to ask how it works with the RFID chip. Can I then simply hold up the originals and it will recognize which label it should simulate?

queengooborg, 2024-07-24:
> Unfortunately I encounter the following error with the "make" command. what do I have to declare there?:

The `DMO_SKU` variable must be defined to specify which SKU you wish to compile firmware for (like `make DMO_SKU=30252`), but it looks like that wasn't documented anywhere.

> I also wanted to ask how it works with the RFID chip. Can I then simply hold up the originals and it will recognize which label it should simulate?

The bluepill will emulate whatever label you've flashed the firmware for, so if you've compiled and flashed the firmware for SKU 30252, that's the SKU that it will emulate.  However, if you've connected the RFID reader and the optional resistors, then if a real tag is detected, it will pass the data through.  Hope this explanation helps!

ChrisGru01, 2024-07-25:
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

I actually did it by changing the main.c file and defining the SCU there. Is that also possible or do I have to do it in the make command?

queengooborg, 2024-07-25:
SKU 30321 has not been added to this repository, but I added it in on my own fork: https://github.com/queengooborg/free-dmo-stm32

From there, you can find a recompiled BIN for the SKU you're looking for too!

ChrisGru01, 2024-07-25:
> SKU 30321 has not been added to this repository, but I added it in on my own fork: https://github.com/queengooborg/free-dmo-stm32
>
> From there, you can find a recompiled BIN for the SKU you're looking for too!

Thanks for compiling.

I'd just really like to figure out what I'm doing wrong and how to add more if necessary. Would it be possible for you to explain it to me? Currently I'm also getting this error:
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

queengooborg, 2024-07-25:
The issue there is a small one -- you just need to replace the underscore with an equals after "SKU" (so `DMO_SKU=30321` instead of `DMO_SKU_30321`), and you should be all good to go!

Closed 2024-07-25.

Thread 48 (2024-08-28):

Frequent disconnects

EldoradoGit, 2024-08-28:
Hi There - i've modified a printer successfully, but it seems to have an issue where it requires frequent restarts of the printer (power light will randomly start flashing). It's happened 3-4 times a day, every day. I've opted to keep the rfid reader attached.

Do you have any recommendations on areas i should look?

KudzuKid, 2024-08-28:
Hi There,

Without knowing exactly the state of things, quality of workmanship, etc.
(no offense, please!), it's hard for me to say.

However, after some fair careers in IT and electronics, I might just make a
guess:

Cold/intermittent/shorting soldered connections?

Normally, as I understand it - the way my 5XL works - I only get the rapid
blink once I start Dymo Connect.  Once I press the power button again, it
behaves for the duration of the power cycle unless/until I quit the app or
power cycle again.

So it makes me think something is 'spoofing' the signal to check the
printer - and if it's happening randomly, then that might be either a bad
solder connection (as above) or perhaps corrupted firmware?  Just guessing.

Perhaps someone with more experience than I can help.

All the best!

On Wed, Aug 28, 2024 at 3:49 PM EldoradoGit ***@***.***>
wrote:

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

EldoradoGit, 2024-08-29:
thanks for the comments! No offense taken, no worries!

I looked over the solder joints, and even reflowed them with air and flux. they look good to me.

one thing i noticed that i didn't notice before is that i dont think the board is genuine. The chip looks genuine when referring to guides online, but the reset button says "RESRT". I'm wondering if that's introducing some instability issues.

Another factor is our implementation is a little different. We are not printing from Dymo Connect, we're using Dymo's API to print directly from our software. I'm wondering if something is happening there...

EldoradoGit, 2024-08-29:
> Hi There, Without knowing exactly the state of things, quality of workmanship, etc. (no offense, please!), it's hard for me to say. However, after some fair careers in IT and electronics, I might just make a guess: Cold/intermittent/shorting soldered connections? Normally, as I understand it - the way my 5XL works - I only get the rapid blink once I start Dymo Connect. Once I press the power button again, it behaves for the duration of the power cycle unless/until I quit the app or power cycle again. So it makes me think something is 'spoofing' the signal to check the printer - and if it's happening randomly, then that might be either a bad solder connection (as above) or perhaps corrupted firmware? Just guessing. Perhaps someone with more experience than I can help. All the best!
> […](#)
> On Wed, Aug 28, 2024 at 3:49 PM EldoradoGit ***@***.***> wrote: Hi There - i've modified a printer successfully, but it seems to have an issue where it requires frequent restarts of the printer (power light will randomly start flashing). It's happened 3-4 times a day, every day. I've opted to keep the rfid reader attached. Do you have any recommendations on areas i should look? — Reply to this email directly, view it on GitHub <#48>, or unsubscribe <https://github.com/notifications/unsubscribe-auth/AF3VKASO3W5KB6X2KQZ7MU3ZTYZWZAVCNFSM6AAAAABNJCAJGGVHI2DSMVQWIX3LMV43ASLTON2WKOZSGQ4TEOJWGY2TEOI> . You are receiving this because you are subscribed to this thread.Message ID: ***@***.***>

I've got some more information.

I noticed that the Dymo will go to "sleep" (power LED gets dim) after 30 seconds if the DymoConnect software isn't running.
The stock/original Dymo will recover from this sleep state, but the modified Dymo will not, requiring a power cycle.

EldoradoGit, 2024-08-30:
And some more information.

With a modified 550 plugged in, and DymoConnect is NOT running, the printer will go to sleep after 30 seconds (USB logo LED on the front goes out).
If I insert an official Dymo roll, OR a generic roll, and then attempt to print the USB LED comes on and the power LED will begin to flash.
If I attempt to print while the USB logo is off and Power is flashing, i will get an "Unknown Label" error in the print queue.

After another 30 seconds the printer will go to sleep again. The USB LED will go out, and the flashing Power LED will stop flashing and go dim.

If I attempt to print again, it will print normally.

So it boils down to if the printer enters sleep from a connected state, it will not detect the label (genuine or generic), and will not print.
If the printer enters sleep from a disconnected/flashing state, it will detect the label and you can print.

Very odd...

Thread 49 (2024-09-25):

Make compatible with other microprocessors

queengooborg, 2024-09-25:
This is probably a far-fetched idea, but given how difficult it is to source genuine blue pills, it might make a lot more sense to make the project compatible with other microprocessors, like the Arduino Nano / Teensyduino.

This suggestion comes from absolutely no research on how difficult it would be to convert the existing codebase, or how challenging it would be to provide support.  My suggestion is purely based on supply chain issues with the STM32 blue pills!

MeisterLone, 2024-09-25:
They arent 'hard to source', i bought 3 on amazon for $3 each. Next day delivery.

queengooborg, 2024-09-25:
I'm talking about _genuine_ bluepills.  Counterfeits are so easy to obtain off of Amazon, eBay and anywhere else, but I have yet to find a seller that provides _genuine_ STM32F103 bluepills.  :)

MeisterLone, 2024-09-25:
See below amz link. 100% geniune chip made by ST
https://a.co/d/h4k4F8b

queengooborg, 2024-09-25:
That's not a compatible board; that's the C6, not the C8.  In the readme of the project: "Some places sell blue pills with STM32F103C6T6 which are not compatible."

MeisterLone, 2024-09-26:
True! My bad- I used a C8 from amz without problems though.

Thread 50 (2024-09-25):

New dymo hardware revision breaks free-dmo

MeisterLone, 2024-09-25:
I am not 100% sure about this one, but it looks like Dymo silently updated hardware in the latest batches of printers. Tested a known working stm32 in both old and new Dymo 550 Turbo printer and it doesnt work on the new printer.  No obvious difference on the model numbers.

apppie123, 2024-09-26:
Is it not being recognized? Or do levels simply not reset anymore?

They have added an eeprom to the board to store label usage.

There was a command added by dymo and this has been added to the firmware. Perhaps your board needs to be reflashed with updated firmware?

eha002, 2024-10-10:
Any updates?

Is this just 550?

Ive seen a few comments saying newer machines not working but cant find anything concrete.

KudzuKid, 2024-10-10:
I suspect SOME (if not all) of the units "not working" are either errors in
the mod (cold, shorted or mis-soldered connections) and/or folks getting
knock-off/counterfeit BluePills. I did my (new at the time) 5XL earlier in
the Spring or so and it went very well.  I've updated Connect several times
with no issues.  I'm personally not sure that Dymo would get a good ROI to
make it worthwhile for them to rewrite firmware/hardware just to give
heartburn to a small minority of users that would be brave enough to do the
hack, let alone install a pre-made hack (e.g.: off eBay, etc.). But
anything's possible and I've been wrong once or twice.  Just my 2¢ - if
anyone else has any more concrete experiences - I'd be interested to hear
it.

BTW, the Betckey labels off Amazon are literally 1/10th the price of the
"authentic" D*mo and work every bit just as well.

Cheers!

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

MeisterLone, 2024-10-11:
@KudzuKid in my specific case, if you read my original comment, I have deployed 550’s that work perfectly fine (counterfeit bluepills). I wont say how many, but quite a few. Over the last year, some of them have worn out and I purchased the exact same model 550 directly from Dymo and transferred the pills from the old working printers to the new ones that visually look exactly the same, without success.

I did not reflash them with the latest code from this project though, so that is something I need to try. I am just using dymo rolls until I get to that. It is just kind of odd that the exact same model printer (visually identical) with a known working pill flashed a year ago dont work together.

KudzuKid, 2024-10-11:
I'm not saying this is the case for you, and I'm not familiar specifically
with the 550 (I have a 5XL), but here's one thing I've personally observed:
The flexible circuit ribbon cables (2) in my 5XL are EXTREMELY short (I
wish I knew where to get longer ones - but too lazy to research right
now).  You can not take the cover completely off without disconnecting them
(either manually or by yanking them out of their ZIF style sockets). So, at
one point, after I reassembled my 5XL for the 2nd or 3rd time - it suddenly
didn't work anymore.  I thought I had bricked it in a re-flash or
something.  Even after I took it back appat, it LOOKED AS IF the
flexi-ribbons were plugged in - and they were, but one of them wasn't
plugged in ENOUGH! After I reseated it, it took off working again.  All
this to say - there are many variables in the mix, some more obvious than
others. That one was a little sneaky.  This from a guy with well over 30
years of electronics and IT experience, sigh, LOL!

Good luck and keep us posted, please!

Best wishes

On Thu, Oct 10, 2024 at 7:06 PM Paul Francis Nel ***@***.***>
wrote:

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

KudzuKid, 2024-10-11:
It might be interesting to examine the contents of any onboard ROMs, NVRAMs
(or wherever the firmware is stored)  if someone could do a comparison to
known "good" (hacked/hackable) units. I've not yet been so interested in
doing a stare & compare / dump of the boards' firmware (presuming they
appear identical as you say). Are you leaving the NFC connected or just
running off the 'pill? In my case, I did the kind of a 'man in the middle'
with it - and connected the NFC board to the 'pill. I guess you don't have
to - but I didn't want to have to take it apart (or outboard the 'pill) and
re-flash the 'pill if I ever changed label types. I hope this makes a
little sense. It sounds interesting. I'd be surprised if D*mo re-wrote code
to check for 'man in the middle' (Audrino, 'pills, Pi's, etc.) But I guess
they could suddenly check for a signature/checksum or something that they
weren't previously doing.  Not a software engineer but I suspect it's
possible to do; BUT the juice has to be worth the squeeze.  All that just
to keep what - maybe a couple of hundred people from using brand X labels?
Please do keep us posted.

On Thu, Oct 10, 2024 at 7:06 PM Paul Francis Nel ***@***.***>
wrote:

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

eha002, 2024-10-11:
@MeisterLone Whats the first 2Letter/Numbers of your Serials that aren't working vs are?

I have 2 GQ13 5XL, 1 QG25 5XL and a QF34  550T that all work.

Im going to try on a QG41 5XL soon to see if it's a no go.

KudzuKid, 2024-10-15:
I have a 5XL... mod works like a champ.

QG2

Hope this helps!

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

eha002, 2024-10-17:
Just an update for everyone

I have got a non-working example that was purchased this year,

It's a full new mainBoard but the rest of the printer is the same including the Reader, So in theory it should be able to be bypassed in a similar way, once someone discovers how its stopping the freedmo from working.
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

apppie123, 2024-10-17:
Are you running the latest firmware from here?
I see several people posting that it doesn't work, but no one is able to tell they are running the latest release that contains communication fixes... Check eevblog. There was a discussion beginning of the year.

eha002, 2024-10-17:
Yeah mate. I have 3 working units and 1 that wont Accept the module.

Ive only pulled 2 apart completely,
But the one that works and one that doesn't have different PCBS

Is working are 2xQG13 1xQG25 & also have a QF34 550T that works.

But a QG41 doesn't work.

xq1xq1xq1, 2024-11-05:
I am unsure where to find the Q model numbers listed above but we have just purchased 4 550 printers in the last 4 weeks so I assume these are the new vintage

We are totally bypassing the RFID board

Dymo Connect sees the printer but says the labels are empty and it does not reflect the label indicated by the firmware that I installed on the bluepill

Any ideas?

KudzuKid, 2024-11-05:
The "Q number" is the serial # - it seems to always with Q, someone was all
about the first 3-4 digits. Trying to track exactly if/when a hardware
change took place. See earlier comments in this thread (or whatever the
proper Git-vernacular is! 🫠). Found on a sticker on the bottom of the unit
I believe. Seemingly, just the first 3-4 characters will tell the story.

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

xq1xq1xq1, 2024-11-06:
Thanks for the clarification

My printers are QE4080

Are these an older model from which is having the problem?

xq1xq1xq1, 2024-11-07:
In my case the label showing up in Dymo Connect does not match the firmware I loaded and it indicates that the printer is empty

xq1xq1xq1, 2024-11-07:
It does not seem to matter which firmware I load, DYMO Connect shows Connected/Empty with the same label every time as 30251/Not in Printer

KudzuKid, 2024-11-07:
Can you describe your hack a little bit?  There are a couple of ways of doing it.  Some people eliminate/bypass/disconnect the RFID reader completely, while another option is to connect it.
In my hack, I used the RFID board and kept it intact since I already had a fair supply of "AUTHENTIC" D*mo labels (I occasionally use a larger shipping label, etc.), but since I typically run brand X labels (Betckey work GREAT for my in my 5XL) - standard address size, there's no RFID core to detect, so it defaults to the 'pill, which is flashed with the appropriate image. 

One time earlier this year, after some experimentation in the early stages after I did the initial hack, I experienced exactly the same issue you are seeing!  Connect said the printer was "Empty" / couldn't detect label type (forget exact verbiage). So I carefully disassembled the 5XL, after examination, I realized one of the 2 flex ribbon cables was not completely seated in the DIP/LIF socket.  It initially LOOKED good but wasn't firmly seated. I pulled and reseated the flex ribbon, reassembled it, and all was well once again.  I'm not saying THIS is your issue categorically, but it might be worth a check.  If Dymo has redesigned hardware somehow to 'work around' the 'pill, I bet there's a way to hack the redesigned units similarly. I do see visual differences between the older and newer boards in a couple photos @eha002 posted recently, but I can't discern component function  & placement.  I'm not really into SMT much and it's easy (for me) to get lost reverse engineering it.  I'm not a hardware engineer, nor do I play one on the internet, LOL.

Best wishes & keep us posted. 

xq1xq1xq1, 2024-11-09:
I checked the ribbon cables you mentioned and they looked good

When I connect in the RFID board from another 550 printer, DYMO Connect recognizes the label correctly for the printer I am working on

But when I plug in the BluePill Dymo Connect shows labels are empty and the last label type that was read by the DYMO RFID board is displayed

Secondary question:

How do I select which label to use that is stored in the Firmware?

apppie123, 2024-11-09:
It might not be the hardware.
I just tried several of the SKU's in this repo and so far none of them work.

Then I loaded the data from some SKU's I got here and they work flawlessly.

Perhaps d*mo has banned the data for the SKU's in this repo?

xq1xq1xq1, 2024-11-11:
Thanks so much for your insights.

Did  you build your own firmware for these SKUs  or is there some some other method of selecting the working SKU?

apppie123, 2024-11-11:
Yeah you would need to re-compile the code and flash it to your bluepill. You can select a different SKU using the #define as explained in the code.
I am trying to get insight which work and which don’t to understand why they do not work. So far it appears that the non working ones are not being sold here.

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

xq1xq1xq1, 2024-11-11:
Cool - I have not build firmware before  - i am spinning up a Debian VM and will give it a shot

I will let you know how I make

Thanks for helping me move down this path!

xq1xq1xq1, 2024-11-11:
I installed the required software from the readme file

```
Option 1: Install the required ARM toolchain from distribution

install the ARM toolchain from distribution (e.g. on Debian-based GNU/Linux install the gcc-arm-none-eabi and libnewlib-arm-none-eabi packages)

run make to compile the firmware

```

I did an initial make on the given Makefile to prove that I have what I need but I get this error:

```
Src/main.c: In function 'InitEmulationWithDefaultData':
Src/main.c:572:31: error: 'DMO_TAG_SLIX2_BLOCKS' undeclared (first use in this function); did you mean 'EMU_SLIX2_BLOCKS'?
  572 |   memcpy(EMU_SLIX2_BLOCKS,    DMO_TAG_SLIX2_BLOCKS, SLIX2_BLOCKS*sizeof(uint32_t));
      |                               ^~~~~~~~~~~~~~~~~~~~
      |                               EMU_SLIX2_BLOCKS

```

line 572 is contained in this block:

```
void InitEmulationWithDefaultData(void) {
  //copy default tag data
  memcpy(EMU_SLIX2_INVENTORY, DMO_TAG_SLIX2_INVENTORY, SLIX2_INVENTORY_LEN);
  memcpy(EMU_SLIX2_SYSINFO,   DMO_TAG_SLIX2_SYSINFO, SLIX2_SYSINFO_LEN);
  memcpy(EMU_SLIX2_SIGNATURE, DMO_TAG_SLIX2_SIGNATURE, SLIX2_SIGNATURE_LEN);
  memcpy(EMU_SLIX2_BLOCKS,    DMO_TAG_SLIX2_BLOCKS, SLIX2_BLOCKS*sizeof(uint32_t));
}
```

As this is my first time I am a bit stuck in what to do to move forward?

Any guidance is appreciated!

xq1xq1xq1, 2024-11-11:
Looking more in the main.c, I found this section:

```
/////////////////////////////////////////////////////////
// DMO emulation data (default emulation after power up)
//

//choose between one of the dumped SKU (roll types) for emulation
//#define DMO_SKU_S0722430  //  54 mm x 101 mm / 2.125 in x 4 in    /  220 pcs.
//#define DMO_SKU_S0722550  //  19 mm x  51 mm / 0.75 in x 2 in     /  500 pcs.
//#define DMO_SKU_S0722400  //  36 mm x  89 mm / 1.4 in x 3.5 in    /   50 pcs.
//#define DMO_SKU_1744907   // 102 mm x 152 mm / 4 in x 6 in        /  220 pcs.
//#define DMO_SKU_30857     //  57 mm x 104 mm / 2.25 in x 4 in     /  250 pcs.
//#define DMO_SKU_30336     //  25 mm x  51 mm / 1 in x 2.125 in    /  500 pcs.
//#define DMO_SKU_30332     //  25 mm x  25 mm / 1 in x 1 in        /  750 pcs.
//#define DMO_SKU_30256     //  59 mm x 104 mm / 2.3125 in x 4 in   /  300 pcs.
#define DMO_SKU_30252     //  28 mm x  89 mm / 1.125 in x 3.5 in  /  350 pcs.
??#define<200e>DMO_SKU_S0722540  //  57 mm x  32 mm / 1.25 in x 2.25 in  / 1000 pcs.
//#define DMO_SKU_S0904980  // 104 mm x 159 mm / 4 in x 6 in        /  220 pcs.
//#define DMO_SKU_
```

and

```
//choose one of the dumped original tags for UID + signature emulation. It does not have to match the dumped data
#define SLIX2_TAG_EMU 1  // 1-12](url)
```

so I think that it should have tried to use this for the label configuration

I am unsure I am unenterprising or if there is an error in main.c (which I doubt )

I am stuck for now :-(

xq1xq1xq1, 2024-11-12:
very much a rookie mistake - there were no option uncommented

once I uncommented an option it worked as expected

xq1xq1xq1, 2024-11-12:
I now have added my tags into main.c for label 30323

DMO_SKU_30323

```
0x03,0x0A,0x82,0xED,0x86,0x39,0x61,0xD2,0x03,0x14,0x1E,0x32,0xB6,0xCA,0x00,0x3C,0xF4,0x6B,0x32,0x4A,0x33,0x30,0x33,0x32,0x33,0x00,0x00,0x00,0x00,0x00,0x00,0x00,0x00,0xFF,0x24,0x01,0x01,0x00,0x00,0x00
0x22,0x04,0x1E,0x00,0x28,0x00,0x00,0x00,0x00,0x00,0x0F,0x00,0xF0,0x03,0x1C,0x02,0x00,0x00,0x00,0x00,0x46,0x02,0xDC,0x00, 0x7A,0x2D,0x16,0x00,0x01,0x00,0x00,0x00,0x00,0x00,0x00,0x00,0x00,0x00,0x00,0x00
0xD7,0xFA,0x00,0x1C,0x78,0xAF,0x49,0xEF,0x04,0x00,0x00,0x00,0x00,0x00,0x00,0x00,0x00,0x00,0x00,0x00,0x00,0x00,0xB8,0x0F,0xC8,0x00,0x00,0x00,0x00,0x00,0x00,0x00,0x00,0x00,0x00,0x00,0x00,0x00,0x00,0x00
0x32,0x8C,0x00,0x30,0x21,0x68,0x44,0x12, 0x00,0x00,0x00,0x00,0x6E,0x30,0x81,0xAC,0x00,0x00,0x00,0x00,0x00,0x00,0x00,0x00,0x00,0x00,0x00,0x00,0x00,0x00,0x00,0x00,0x00,0x00,0x00,0x00,0x00,0x00,0x00,0x00
0x00,0x00,0x00,0x00,0x00,0x00,0x00,0x00,0x00,0x00,0x00,0x00,0x00,0x00,0x00,0x00,0x00,0x00,0x00,0x00,0x00,0x00,0x00,0x00,0x00,0x00,0x00,0x00,0x00,0x00,0x00,0x00, 0x00,0x00,0x00,0x00,0x00,0x00,0x00,0x00
0x11,0xF3,0x00,0x2C,0xDD,0xC3,0x3E,0x91,0x00,0x00,0x00,0x00,0x00,0x00,0x00,0x00,0x00,0x00,0x00,0x00,0x00,0x00,0x00,0x00,0x00,0x00,0x00,0x00,0x00,0x00,0x00,0x00,0x00,0x00,0x00,0x00,0x00,0x00,0x00,0x00
0x00,0x00,0x00,0x00,0x00,0x00,0x00,0x00,0x00,0x00,0x00,0x00,0x00,0x00,0x00,0x00, 0x00,0x00,0x00,0x00,0x00,0x00,0x00,0x00,0x00,0x00,0x00,0x00,0x00,0x00,0x00,0x00,0x00,0x00,0x00,0x00,0x00,0x00,0x00,0x00
0x00,0x00,0x00,0x00,0x00,0x00,0x00,0x00,0x00,0x00,0x00,0x00,0x00,0x00,0x00,0x00,0x00,0x00,0x00,0x00,0x00,0x00,0x00,0x00,0x00,0x00,0x00,0x00,0x00,0x00,0x00,0x00,0x00,0x00,0x00,0x00,0x0E,0xFF,0x00,0x01
```
I did a make on the firmware file and then loaded this firmware into the bluepill

Unfortunately the lights on the front of the are flashing and DYMO Connect shows labels are empty

I have attached my main.c file for reference

Any thoughts?

[main.c.txt](https://github.com/user-attachments/files/17723089/main.c.txt)

xq1xq1xq1, 2024-11-12:
I added only the hex after the BLOCK: statement into the main.c

I did not add anything for the SLIX2_TAG_EMU section after the Define Statements though

I did not do anything with main.c for the sections:

- inventory
- sysInfo
- signature

is this data to be added somewhere into main.c?

xq1xq1xq1, 2024-11-12:
I read the main.c comments closer :-O

I will add the Inventory, sysinfo and signature data into main.c tomorrow and let you know how I make out

xq1xq1xq1, 2024-11-13:
I added all of the Tag information into the appropriate spots in main.c and reflashed the bluepill for label 30323

DYMO Connect shows:

- Label 30251 not 30323
- Connected
- Empty

I am not using the RFID Board

Has anyone has success with not using the RFID board as part of the emulation?

apppie123, 2024-11-13:
Did you try several different types of labels?
For me many of them don’t work.

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

xq1xq1xq1, 2024-11-13:
I purchased a new box of 30323 labels from DYMO and extracted the RFID Tags and inserted them into main.c

These are the labels that we need to print on.

My thought was that if the label is current and that RFID tag is extracted that it should work but I could be totally off base.

Do you have an example of a label that did work for you?

xq1xq1xq1, 2024-11-13:
Do you have the original RFID board connected to the Bluepill?

Axis-3790, 2024-11-13:
> Are you running the latest firmware from here? I see several people posting that it doesn't work, but no one is able to tell they are running the latest release that contains communication fixes... Check eevblog. There was a discussion beginning of the year.

I can confirm this is working on my end. I bought a brand new 5xl about a month ago and no problems on my end using the latest firmware.

Rant - Dymo has been a b***h to work with. I have a 450 turbo I am working on fixing. The main selling point for the new 5' series is the ability to print via lan without the need of a print server.

KudzuKid, 2024-11-13:
Nice meet another 5XL user!

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

xq1xq1xq1, 2024-11-14:
I purchased a new box of 30323 labels from DYMO and extracted the RFID Tags
and inserted them into main.c

These are the labels that we need to print on.

My thought was that if the label is current and that RFID tag is extracted
that it should work but I could be totally off base.

@apppie123 <https://github.com/apppie123> Do you have an example of a label
that did work for you?

Do you have the original RFID board connected to the Bluepill?

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

Axis-3790, 2024-11-29:
Well I finally got the new revision.. Any suggestions? I have 2 Dymos with the new board. The printer refuses to take the emulated tag. I even extracted data from a new roll of Dymo labels and nothing.  I am willing to experiement if someone has any ideas.

Darxtek, 2024-12-02:
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

Did you ever get a resolve for this?

Darxtek, 2024-12-02:
After tinkering with a few 550 turbo units, I get my printer connected but stuck on mismatched label (30251) can’t change the label size, and says (i) not in printer.

wondering if this is a patched printer or bad SKU
SERIAL QF42

xq1xq1xq1, 2024-12-03:
I did not resolve this issue yet, I am still fighting with it.  Mine is
stuck on 30251

Anyone that figures it out let me know :-)

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

apppie123, 2024-12-03:
Perhaps 30251 is some kind of default they put in there.
To proceed we would need logs of the communication between the bluepill and d*mo board.

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

Thread 51 (2024-10-15):

I need help compiling

HolgerS72, 2024-10-15:
Hello everyone,

I need help compiling.

When I try to compile on different operating systems.

Macos

Ubuntu

everything always comes down to one error.

make CC=/Users/holger/installer/gcc-arm-none-eabi-10.3-2021.10/bin/arm-none-eabi-gcc /Users/holger/installer/gcc-arm-none-eabi-10.3-2021.10/bin/arm-none-eabi-gcc -c -mcpu=cortex-m3 -mthumb -DUSE_HAL_DRI VER -DSTM32F103xB -IInc -IDrivers/STM32F1xx_HAL_Driver/Inc -IDrivers/STM32F1xx_HAL_Driver/Inc/Legacy -IDrivers/CMSIS/Device/ST/STM32F1xx/Include -IDrivers/CMSIS/Include -std=c99 -Wall -Os -DDMO_SKU_ -Wall. sections -ffunction-sections -MMD -MP -MF"build/main.d" -Wa,-a,-ad,-alms=build/main.lst Src/main.c -o build/main.o Src/main.c: In function 'InitEmulationWithDefaultData': Src/main.c:572:31: error: 'DMO_TAG_SLIX2_BLOCKS' undeclared (first use in this function); did you mean 'EMU_SLIX2_BLOCKS'?
 572 | memcpy(EMU_SLIX2_BLOCKS, DMO_TAG_SLIX2_BLOCKS, SLIX2_BLOCKS*sizeof(uint32_t));
 | ^~~~~~~~~~~~~~~~~~~~ | EMU_SLIX2_BLOCKS
Src/main.c:572:31: note: each undeclared identifier is reported only once for each function it appears in
make: *** [build/main.o] Error 1

Can someone please explain to me what I'm doing wrong.

Thank you in advance

Holger

HolgerS72, 2024-10-15:
it's done,

thanks anyway

Closed 2024-10-15.

Thread 54 (2025-01-31):

sku-S0722540 half working from last realease

kestutiz, 2025-01-31:
Hello,
I'm new here and made some tests. Very thanks for the project. It bring me into microcontrollers area to learn a bit.

I found that compiled sku-S0722540 (11354) of 1.1.0 and 1.1.1 realeases working "silently" or in half I can say.
Software shows empty printer and still prints. Looks like a bug.
But from 1.0.7 works great.
Spend a lot of time to check soldering errors or so but was just bug here.
Tested on 5XL, 550 and 550 turbo.

Small note. sku-S0722400 probably dumped from starter roll of 52 labels. Not a problem if you use it a lot to power off/on. I'll look if I have spare to make full roll dump.

Thread 55 (2025-03-28):

Did D*mo Connect 1.4.6.37 Just Kill My Bluepill'd 5XL?!?

KudzuKid, 2025-03-28:
Hi There,

Well, worst fears realized... Perhaps!

Earlier today my son "upgraded" my D*mo Connect to the latest version - I forget what version I WAS running, but after "upgrade" it's currently at v. 1.4.6.37 and the 5XL is now crazy.  It's serial # leading digits are:  QG1290______, doing the original Bluepill mod.  Am I permanently hosed now?  I tried uninstalling Connect, and reinstalling an earlier version (I only saw one version available from Dymo site - so it could be tainted), but no joy. Whenever I power up or try to print the unit constantly blinks.

I welcome any thoughts. I'm rapidly reaching a point where I'll either need to abort the 5XL and buy something else (Epson? Brother?) or get the Dymo working.  I have a project coming up and I'll need it!  I love being able to use the non-DRM'd Betckey labels from Amazon!  Would re-flashing BluePill with the original firmware help?  I'm at a loss on how to proceed!

Any hints, tips, tea & sympathy are **GREATLY** appreciated!

jorisvergeer, 2025-04-10:
I think your best option is to buy a non-drm printer from epson or brother indeed.
You are not going to get your dymo working with a reflash, or maybe you will. But it's not worth failing a project over it.

Thread 56 (2025-04-15):

[IDEA] - Selectable label type

bretterer, 2025-04-15:
Its hard to get around not using Dymo label printers, especially with the web connect driver they offer. I have tried to build one for Brother printers, but no luck.  This brings me to my idea.

I would like to know if it would be possible to add, lets say 10 different label types into the STM32 and connect something like a dipswitch connector, or some other physical switch. This way I can swap the label types out between things like 30333, or the 30346 labels.  I do switch between these fairly often and would love to not have to re-program it each time I swap.

What are your thoughts on something like this.  Is it even possible?

J0nnyBr4v0, 2025-06-01:
That is what I'm also looking for...  Or maybe connect an esp32 module and send emulated data (as there are already a load of dumps available?) and be able to select it from a web interface?  But it's going over my head, was just an idea...
