free-dmo/free-dmo-stm32/(commit log)

2022-03-29 add new tag + data from SKU 1744907 (4" x 6" / 102 x 152mm)
2022-04-04 add new tag + data from SKU 30857 (2.25" x 4" / 57 x 104mm)
2022-04-06 add new tag + data from SKU 30336 (1" x 2.125" / 25mm x 51mm)
2022-04-14 add new tag + data from SKU 30332 (1" x 1" / 25mm x 25mm)
2022-04-14 add note for incompatible blue pill boards which use wrong STM32 IC (STM32F103C6T6 instead of STM32F103C8T6)
2022-04-21 add SKU 30256 (59 mm x 104 mm / 2.3125 in x 4 in / 300 pcs.)
2022-08-28 change the JST type to GH (which seems to be correct 1.25mm spacing"
2024-04-22 add support for SLIX2 command NXP System Infomation (the r in information is missing in NXP official document)
    [main.c]
2024-12-16 fix wrong register index in init of real RFID board
    [main.c]
2024-12-16 fix NXP SYSTEM INFOMATION request to real tag on spool (fixes pass through)
    [main.c]
